M2I-CySat/CySat-1-Mission-Analysis/Two Day Ground Path/Two Day Ground Path.bmp

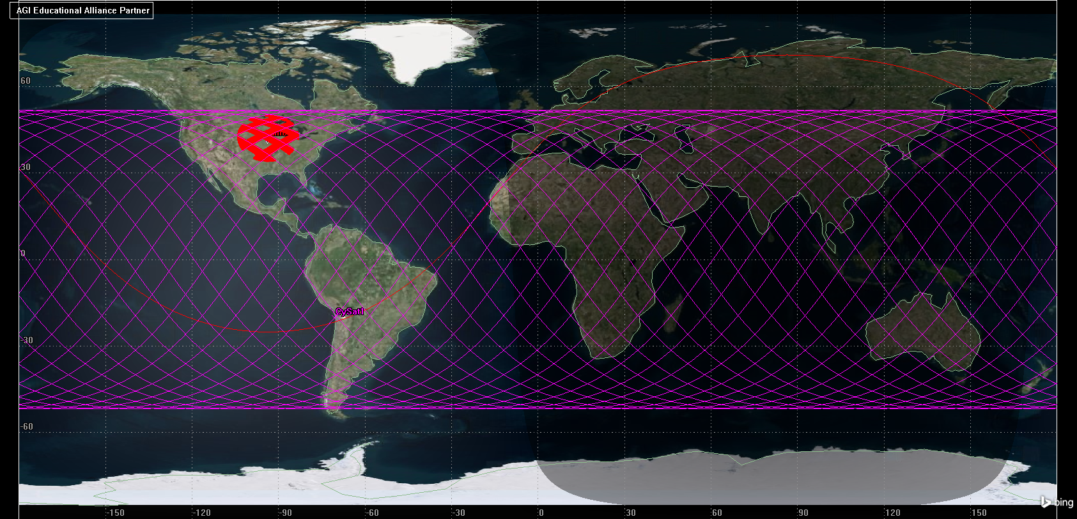
Two Day Ground Path/Two Day Ground Path.bmp
