M2I-CySat/CySat-1-Mission-Analysis/README.md

# CySat1-Mission_Analysis
CySat-1 Mission Analysis files and documentation
