M2I-CySat/CySat-1-Mission-Analysis/ConOps (3).docx

CySat-I Concept of Operations

Iowa State University

Author(s): Role

Mackenzie Kilcoin Team Lead

Jacob Goldenberg Team Member

Benjamin Sweet Team Member

Benjamin Halley Team Member

William Rickert Team Member

Matthew Nelson Faculty Advisor

Tomas Gonzalez-Torres Faculty Advisor

6 June 2018

Table of Contents

1 Mission Concept. . . . . . . . . . . . . . . . . . . . . . . . . . . . . . . . . . . . 4

2 Mission Phases. . . . . . . . . . . . . . . . . . . . . . . . . . . . . . . . . . . . . 4

2.1 Phase One. . . . . . . . . . . . . . . . . . . . . . . . . . . . . . . . . . . . . 4

2.2 Phase Two. . . . . . . . . . . . . . . . . . . . . . . . . . . . . . . . . . . . . 4

2.3 Phase Three. . . . . . . . . . . . . . . . . . . . . . . . . . . . . . . . . . . . 4

2.4 Phase Four. . . . . . . . . . . . . . . . . . . . . . . . . . . . . . . . . . . . . 4

3 Subsystem Description. . . . . . . . . . . . . . . . . . . . . . . . . . . . . . . . . 5

3.1 Structures. . . . . . . . . . . . . . . . . . . . . . . . . . . . . . . . . . . . . . 5

3.1.1 Dimensions . . . . . . . . . . . . . . . . . . . . . . . . . . . . . . . . . . . 5

3.1.2 Mass. . . . . . . . . . . . . . . . . . . . . . . . . . . . . . . . . . . . . . . 5

3.1.3 Material Composition. . . . . . . . . . . . . . . . . . . . . . . . . . . . . . 5

3.1.3.1 Micrometeoroids. . . . . . . . . . . . . . . . . . . . . . . . . . . . . . . . 5

3.1.4 Thermal Considerations. . . . . . . . . . . . . . . . . . . . . . . . . . . . . 6

3.1.5 Launch Environment. . . . . . . . . . . . . . . . . . . . . . . . . . . . . . . 6

3.2 Power. . . . . . . . . . . . . . . . . . . . . . . . . . . . . . . . . . . . . . . . 6

3.2.1 Solar Array. . . . . . . . . . . . . . . . . . . . . . . . . . . . . . . . . . . . 6

3.2.2 Electronic Power System. . . . . . . . . . . . . . . . . . . . . . . . . . . . 6 3.3 Communications and Data Handling. . . . . . . . . . . . . . . . . . . . . . . . 7

3.3.1 Radio. . . . . . . . . . . . . . . . . . . . . . . . . . . . . . . . . . . . . . 7

3.3.2 Ground Station. . . . . . . . . . . . . . . . . . . . . . . . . . . . . . . . . 7 3.3.3 Flight Computer. . . . . . . . . . . . . . . . . . . . . . . . . . . . . . . . . 7

3.3.4 Antenna Deployment. . . . . . . . . . . . . . . . . . . . . . . . . . . . . . 8

3.4 Payload. . . . . . . . . . . . . . . . . . . . . . . . . . . . . . . . . . . . . . . 8

3.4.1 Radiometer. . . . . . . . . . . . . . . . . . . . . . . . . . . . . . . . . . . 8

3.4.2 Computational Resources. . . . . . . . . . . . . . . . . . . . . . . . . . . . 8

3.4.3 AD/DAC RF Front End. . . . . . . . . . . . . . . . . . . . . . . . . . . . . . 9

3.4.4 Antenna Array. . . . . . . . . . . . . . . . . . . . . . . . . . . . . . . . . . 9

3.5 Attitude Determination and Control. . . . . . . . . . . . . . . . . . . . . . . . . 9

3.5.1 Detumbling. . . . . . . . . . . . . . . . . . . . . . . . . . . . . . . . . . . 10

3.5.1.1 Coarse Detumbling. . . . . . . . . . . . . . . . . . . . . . . . . . . . . . 10

3.5.1.2 Fine Detumbling. . . . . . . . . . . . . . . . . . . . . . . . . . . . . . . 10

3.5.2 Station Keeping. . . . . . . . . . . . . . . . . . . . . . . . . . . . . . . . . 10

3.5.2.1 Disturbances. . . . . . . . . . . . . . . . . . . . . . . . . . . . . . . . . 10

3.5.3 Momentum Desaturation. . . . . . . . . . . . . . . . . . . . . . . . . . . . 10

3.5.3.1 Desaturation. . . . . . . . . . . . . . . . . . . . . . . . . . . . . . . . . 10

1 Mission Concept

CySat at Iowa State University is designing, building, and flying a 3U CubeSat (3 Unit Cube Satellite) in Low Earth Orbit (LEO). It is to be a technology demonstrator that will be used for asteroid-surveying purposes.

2 Mission Phases

There are four main phases that CySat-I will transition through during its life. Each phase has its own purpose and is described below.

2.1 Phase One

The first phase is Passive Beacon Mode. This mode involves a beacon that when received, relays an ASCII message containing minimal system status information and a welcome message for radio amateurs. The purpose of this mode is primarily to give confirmation that CySat-I is partially functional.

2.2 Phase Two

The second phase is Diagnostic Mode. This mode involves the gathering and down-linking of data samples from the electronic power system (EPS) board that characterize CySat-I’s orbit and health status.

2.3 Phase Three

The third phase is Main Operating Mode. This mode involves the changing of operating parameters for the payload to perform any desired scientific experiments. All data is logged to the core-memory heap and down-linked during passes over Iowa

State University’s ground station.

2.4 Phase Four

The final phase is End of Life Mode. Here, the watchdog test routines will be performed to test the implemented redundancies. The attitude of CySat-I can also be adjusted during this phase to increase the drag, allowing the CubeSat to re-enter Earth’s atmosphere faster.

3 Subsystem Description

Each subsystem is contained in this section with a purpose statement along with how the subsystem functions. This should quickly acquaint the user as to what hardware and software is aboard CySat-I, why the subsystem is critical to the operation of the CubeSat, and what protocols are being utilized. Ideally, this document will provide any experienced user with the information necessary to communicate and control CySat-I as well as troubleshoot any potential problems that may arise over its lifetime.

3.1 Structures

This subsystem is focused on the physical design of the CySat-I skeleton. Size, shape, and mass all affect the final shell of the CubeSat. Since CubeSats follow a template, the shape is limited to a rectangular prism, the dimensions are constrained to that of the 3U specifications, and the mass has an upper limit.

3.1.1 Dimensions

The dimensions of CySat-I is limited to that of three, 1U CubeSats. Since each 1U is 10 cm²; that means that CySat-I’s dimensions will be 10 × 10 × 34, with the extra 4 cm coming from the excess material of the feet and allowed tolerances of outside material. While there is some slight buffer room for stowed, deployable components, these dimension specifications are relatively strict to adhere to the NanoRacks CubeSat Deployer (NRCSD) that it will launch from.

3.1.2 Mass

CubeSats also have mass limitations. There are multiple reasons for this, with the main reason being that CubeSats are getting a free ride to their destination, so there is a limit to how much extra mass a rocket can deliver. 3U CubeSats are limited to a maximum mass of 4.8 kg, however CySat-I’s mass will be less than this. The current mass of CySat-I is 2.6 kg.

3.1.3 Material Composition

The shell of CySat-I is made of 6061-T6 Aluminum. The other structural components, such as rods, spacers, and screws, will be composed of 18-8 Stainless Steel.

3.1.3.1 Micrometeoroids

Research suggests that the ISS receives a lot of micrometeoroid impacts, but many of them are under 1 cm which poses no danger to the ISS. Micrometeoroids larger than 1 cm are in the danger zone as they can cause catastrophic failure and are not tracked by stations on Earth. Since the structure’s thickness is set by the design template, there is not much that can be done to prevent impacts. If there is a large impact, a total mission failure will likely occur.

3.1.4 Thermal Considerations

The temperature gradient that the ISS experiences (due to its altitude and attitude) is extremely important to consider when selecting material composition, instrumentation placement, and a heat control system. To begin, the temperature swing that the ISS experiences can be as low as -157◦C to as high as 121◦C. The material chosen has been proven to handle a temperature gradient as large as this, however, it is important that there is a method to dissipate as well as to retain the heat from both the environment and internal components. Currently, there are plans for passive thermal control, meaning heat sinks to the structure or metal blocks if there is enough space. The EPS itself does have a form of active thermal control.

3.1.5 Launch Environment

The two loads that structures is focused on will be the static loading and random vibrations due to the launch forces of the rocket, as well as the shock force due to stage separation and deployment. To ensure mission success, a vibration test will take place prior to CySat-I’s departure.

3.2 Power

The purpose of the power subsystem is to appropriately provide and distribute power to all the subsystems. The power system is comprised of two primary components: the solar array and the EPS Because the batteries will be mated to the EPS, they are not considered a third component. During daytime, light that strikes solar array will power the satellite and recharge the batteries so that during eclipse periods, the satellite can run off of battery power.

3.2.1 Solar Array

At the moment, it is known that CySat-I will utilize an in-house built solar array to power the various subsystems. The original plan was to create an in-house solar array using two types of solar cells, the Spectrolab XTJ Prime solar cell and the Trisolax T01 solar wing, in an effort to maximize solar absorption. Both cells are SolarCell-Interconnect-Coverglass (CIC). Some of the Spectrolab XTJ Prime solar cells were donated to the university from a previous ISS mission and are being tested to ensure the same efficiency as those bought directly from the shelf. As many as twelve of these cells will be deployed with CySat-I.

3.2.2 Electronic Power System

CySat-I will employ a COTS EnduroSat EPS. At this time, two Lithium-ion Polymer (LiPo) batteries are being used. The mission was planned primarily around one 20 Wh battery, but this estimate awaits the arrival of the EPS system slated for the end of June. The batteries will be mated to the EPS. The constraints that will determine this number will be found from solar exposure experience (which can be approximated to that of the International Space Station) and the power usage per system. Currently, a full power budget is about 14 Wh but requires further testing of physical components prior to completion.

3.3 Communications and Data Handling

The purpose of the communications system is to provide telemetry, command, and control to and from Earth. The purpose of command is quite literally to command the system as a whole to perform operations. This is the most important part of CySat-I because a failure in the command software could lead to a mission critical failure. Since no communication can be performed for approximately 90 minutes following deployment, the CubeSat must be able to act autonomously in order to perform system checks and to enable communication to take place. The communication engagement will allow the ground station at ISU to attempt contact with CySat-I for control as well as allow radio amateurs receive a welcome message beacon. The hardware that comprises the command subsystem consists of two auxiliary boards: a custom in-house flight computer and two variations of control circuitry.

3.3.1 Radio

CySat-I will use an AstroDev He-100 radio to perform communication tasks. The radio will use an up-link frequency in the very high frequency (VHF) 2 m band (144 to 146 MHz) and a down-link frequency in the ultra-high frequency (UHF) 70 m band (435 to 438 MHz). By selecting frequency bands in the low end of the HF range, well into the mm range, it is possible to minimize the technical requirements of the satellite and maximize the ease-of-use by ground personnel and amateur radio operators. These two bands allow the lowest level FCC issues amateur radio license holders (i.e. technician level) to operate with CySat-I. The radio provides 1200 baud audio frequency-shift keying (AFSK) and 9600 Gaussian Minimum Shift Keying (GMSK) and AX.25 framing for ease of use. The system will be responsive to published commands from amateurs to query satellite state. Using cryptographic peripheral of MCV, mission critical control messages will be authenticated via a Hash-Based Message Authentication Code.

3.3.2 Ground Station

The software for the ground tracking of CySat-I will be a lights out, hands off, autonomous ground control system. The existing hardware facilitates flexible, reliable data communication on a range of frequencies appropriate for satellite operation. Open MCT, a mission control framework software developed by NASA, is being used for the graphical user interface (GUI).

3.3.3 Flight Computer

The flight computer contains two identical STM32F4 32 bit ARM micro-controller units (MCU) for redundancy; one as the primary unit and the other as the secondary “watchdog” unit in the case of a failure of the primary. The main memory consists of four 1 Mbit external ferromagnetic memory integrated circuit (IC). The lower-half of each IC will be dedicated to radiation resistant firmware back-ups, cryptographic keys, and various other sensitive data items. The upper-half of each IC will be combined to form a large heap for data storage prior to down-link. This will form 512 KB of main memory. The primary multipoint control unit (MCU) software has been developed around FreeRTOS and the basic peripheral library for the STM 32. A multi-threaded approach was taken for the device drivers. The following tasks run in dedicated threads:

- Universal asynchronous receiver-transmitter (UART) communication with radio
- Command parsing and protocol layer
- Command handling, configuration, and response generation
- Main memory access
- Beacon

SPI and I2C are not handled by dedicated threads. Each of these buses uses a mutex- protected direct memory access (DMA) driver to allow a single thread to seize the bus and perform high-throughput data transfer while another thread is allowed to run. The flexibility of the STM 32 standard peripheral library allows for advanced low-level access to the MCU including a UART boot-loader that can be used to perform an emergency re-flash of the MCU in the case of radiation corruption. Identical firmware will be on both MCUs. The difference in functionality will be set by hardware general-purpose input/output (GPIO) configurations and detected at startup. Each MCU will force the invalid one to reset and reprogram it with a firmware image from main memory. The primary-watchdog configuration will provide resistance to radiation corruption.

3.3.4 Antenna Deployment

The antenna that will be used for communication between CySat-I and the Ames Ground Station will be composed of a tape measure. It will be strapped down to the sides of CySat-I, held in that position by ultra-high-molecular-weight polyethylene (Spectra) fishing wire that will be tied around a 1 cm thick filament of nichrome. A burner circuit will apply a 0.5 A current which will burn the Spectra fishing wire, deploying the antennas by utilizing the spring force of the displaced tape measure.

3.4 Payload

The purpose of the payload is to give CySat-I the sensors it needs to perform its scientific mission.

3.4.1 Radiometer

The radiometer will passively measure radiant flux from the soil below in order to map soil moisture. This system will be comprised of a single horn antenna, multiple low-noise amplifiers and band-pass filters, and a software-defined radio. Because a software-defined radio is coupled to the radiometer, the system will have high levels of flexibility and adaptability while operating in LEO.

3.4.2 Computational Resources

A Xilinx Zynq chipset combines the programmable logic of a traditional field-programmable gate array for pipelining radio frequency processing, with a duel core advanced reduced instruction set computing machine Cortex fixed logic. This unifies the computational resources of the computational matrix representation (CMR) and decreases system complexity over a more distributed design. This does create a singular point of failure for the radar system, however, architectures with separated programmable logic (PL) and fixed logic (FL) suffer from the same poor survivability in the event of a failure of one of the subsystems.

3.4.3 AD/DAC RF Front End

At the moment, the specifics of the radio frequency (RF) front end are not known, where the specifics include the number of low-noise amplifiers (LNA’s) and band pass filters (BPF’s), supporting devices, and performance estimates. What is known, however, is the fact that LNA’s and BPF’s will be present on the RF frond end. The LNA’s will be arranged according to the amount of noise generated by the device—the LNA with the least amount of noise generation will be first, followed by LNAs with larger noise generation in increasing order. This arrangement will incur the least amount of noise generated by the system as a whole.

3.4.4 Antenna Array

The antenna array for the radiometer will be comprised of a single horn antenna, created in-house. Phased arrays create the performance of a much larger antenna, and will be necessary to create the necessary gain for optimal radiometer operation. Primary operational goals include detecting and mapping the distribution of radiant flux over time. The single horn antenna will be placed on the front face of the CubeSat. The radiometer will receive signal on the internationally-protected frequency of 1.4 to 1.41 GHz, so the antenna array will be capable of reading these signals.

3.5 Attitude Determination and Control

The attitude, determination, and control system (ADCS) is responsible for orienting CySat-I is in space. CySat-I’s ADCS system was purchased from CubeSpace and consists of both an Earth sensor and a Sun sensor, a magnetometer, 3 magnetic coils (magnetorquers) and a single reaction wheel. The system is composed of three types of components: sensors, controls, and actuators. The sensors are responsible for gathering the relevant telemetry so that the current orientation of the satellite can be determined. The control algorithms process this information and send commands to the actuators. The actuators then turn the spacecraft to the desired orientation. CySat-I is an Earth-observing nadir-pointing satellite. This is the main goal of the ADCS, however it will also have to successfully stabilize the spacecraft from its initial tumbling motion after deployment. This section will focus on the four main parts of the attitude determination and control subsystem: detumbling, station keeping, momentum desaturation, and contingencies.

3.5.1 Detumbling

When ejected from the dispenser, the spacecraft can be expected to have a tumbling rate of up to 300◦/s. The tumbling rate post deployment will exceed the maximum slew rate that the optical sensors can determine the position during. As such, a passive detumbling capability is required. Passive detumbling will be achieved with magnetic torque rods which will be turned on automatically as part of the early startup of the spacecraft. The magnetorquers produce a control torque calculated from the magnetometer reading of Earth’s magnetic field. The net torque produced via interaction with earth’s magnetic field is weak and the coarse detumbling process is expected to take on the order of hours to achieve a stable slew rate. An inertial measurement unit will determine the angular rate. When the slew rate is under a certain threshold, the control software will begin producing control torques that align the satellite in its proper nadir plane, and spinning down the satellite so that it stays pointed at the earth. At this point the momentum wheel will spin up, which provides gyroscopic stability in the orbit/nadir plane, rejecting disturbance torques more easily than the magnetorquers. Detumbling is complete when CySat-I has achieved a steady nadir pointing state where angular position can be held with ±2 degrees of accuracy.

3.5.2 Station Keeping

To remain pointed at Earth below, the spacecraft will have to rotate one full revolution per orbit. At an orbital period of approximately 90 min, this amounts to 4◦/s. If the spacecraft’s z-axis is aligned with the velocity vector, this rotation takes place purely in the Y-Z plane and is maintained with the momentum wheel. Otherwise, it will involve an angular position change of all three axes. This will be computed and executed autonomously by the ADCS.

3.5.2.1 Disturbances

There are four major disturbances that will affect the station keeping of CySat-I. These disturbances are a source of constant torque that can add to momentum saturation of the momentum wheel. Worst case magnitudes of these torques are a gravity gradient of 0.44 N mm, a magnetic dipole of 6.0 × 10⁻⁴ N mm, solar radiation pressure of 1.91 × 10⁻⁵ N mm, and aerodynamic drag of 1.56 × 10⁻⁴ N mm.

3.5.3 Momentum Desaturation

The momentum wheel has a maximum spin rate and therefore can only reject torque for a certain amount of time before becoming saturated at the max spin rate. At this point the momentum wheel must be spun down, however, doing so imparts the angular momentum that is stored in the wheel back into the spacecraft’s motion. As such, a secondary actuator is needed to reject this momentum in the desaturation procedure.

3.5.3.1 Desaturation

Magnetorquers are used to desaturate the momentum. A magnetic moment is created by activating the magnetorquer. The direction of this torque depends on the direction of the Earth’s magnetic field at the time, which can be determined with a magnetometer. The magnetorquers are activated in such a way that the net magnetic torque acts opposite the torque created by spinning down the reaction wheel. The maximum magnitude of the magnetic torque dictates the rate at which the reaction wheel can be spun down. Once the wheel has been spun down to zero speed, the magnetorquer is turned off.

Concept of Operations Page | 11
