M2I-CySat/CySat-1-Mission-Analysis/EnduroSat BOM 07Feb2018 copy.xlsx

Classification: (if proprietary)
EnduroSat 1
Material | Quantity | Unit* Mass (g) | Total Mass (g) | Unit Surface Area cm2 | Usage
EPS
PCB material - FR4 | 1 | 34.8 | 34.8 | 83.9 | PCB (one side)
Aluminum 6061 | 1 | 72 | 72 | - | EPS box
NC-SMQ 92H solder paste | 1 | 1 | 1 | 1 | Solder paste
Black Glass Filled Polyester (see datasheet) | 1 | 31.6 | 31.6 | 42 | PC 104 Connector (insulator material) (http://suddendocs.samtec.com/catalog_english/esq_th.pdf)
High Termoplatic Thermoplastic resin (see datasheet) | 9 | 0.3 | 2.7 | - | connectors (http://bg.farnell.com/molex/53261-0471/wire-board-connector-header-4pos/dp/2424535?mckv=sBVXa6kQi_dc|pcrid|93196729276|kword|53261%200471|match|p|plid|&CMP=KNC-GBG-GEN-SKU-MOLEX&DM_PersistentCookieCreated=true&gclid=Cj0KCQjw9afOBRDWARIsAJW4nvyeg_RIJQo7JQt4OeyoRIKf3Q2n4Pk5UAv5hqWSUEikG8ZtKXl78HwaAkAiEALw_wcB)
Stainless steel 10.9 | 2 | 0.9 | 1.8 | - | M3 fasteners
Common circuit board components materials (capacitors, resistors, inductors, etc.) | 1 | 10 | 10 |  | Components
Battery pack (2x)
PCB material - FR4 | 1 | 15.3 | 15.3 | 58.8 | PCB
Loctite Stycast 4350 | 1 | 7.5 | 7.5 | 52.3 | Thermal conductive silicon rubber
NC-SMQ 92H solder paste | 1 | 0.5 | 0.5 | 0.5 | Solder paste
Li-po batteries | 2 | 25 | 50 | - | Batteries
Brass | 2 | 0.3 | 0.6 | - | Spacers
Common circuit board components materials (capacitors, resistors, inductors, etc.) | 1 | 3 | 3 |  | Components
