M2I-CySat/CySat-1-Mission-Analysis/main.SLDPRT

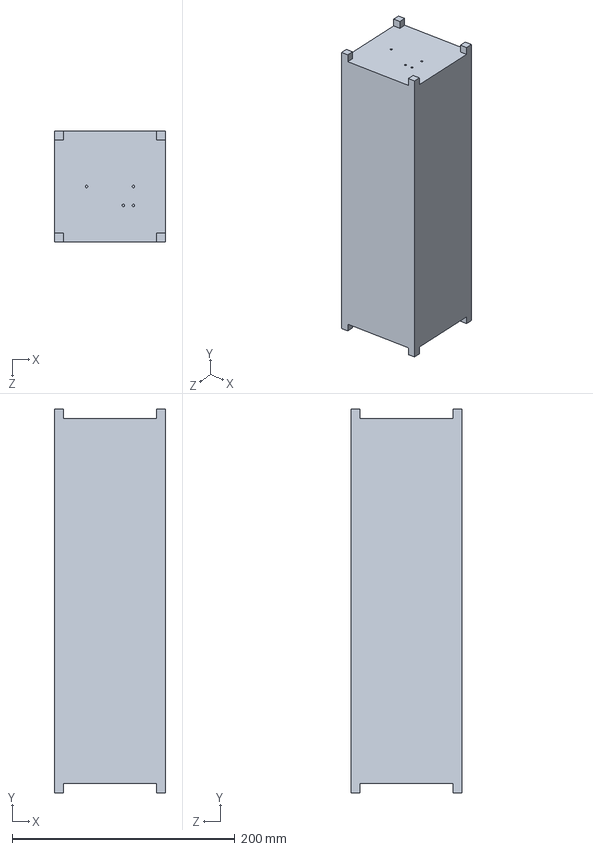
[picture p2: CAD file, 2018-06-22]
main.SLDPRT
100.0 x 344.5 x 100.0 mm
