M2I-CySat/CySat-1-Mission-Analysis/lowfi.SLDASM

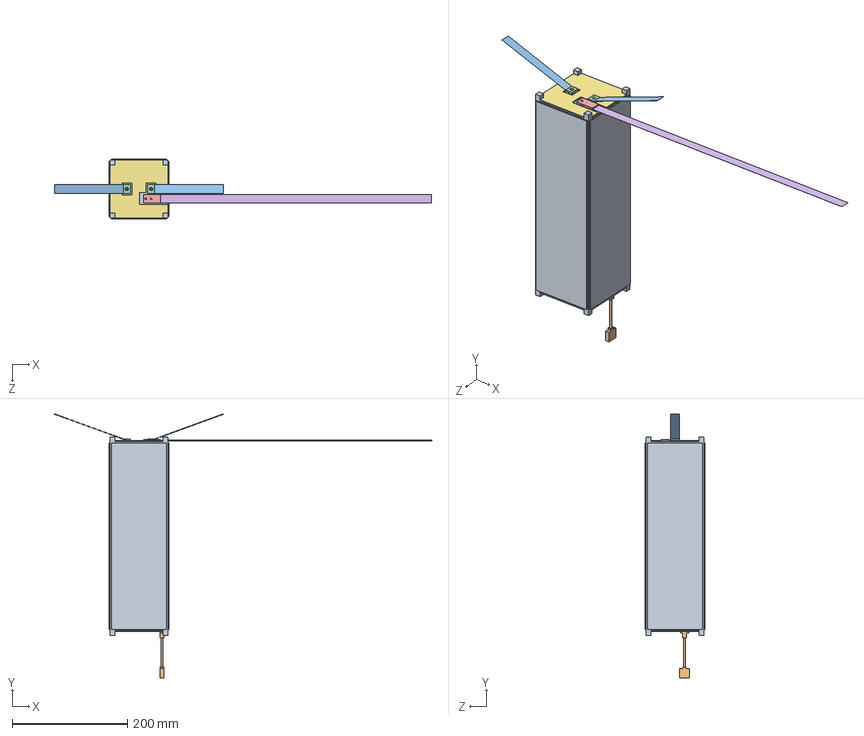
[picture p3: CAD file, 2018-06-22]
lowfi.SLDASM
654.1 x 458.0 x 104.0 mm
main
Dipole Antenna Mount Bottom x 2
Dipole Deployed x 2
Dipole Antenna Mount Top x 2
Mono Antenna Mount Bottom x 2
Monopole Deployed
top panel1
bottom panel
side panel x 4
mag
