M2I-CySat/CySat-1-Mission-Analysis/top panel1.SLDPRT

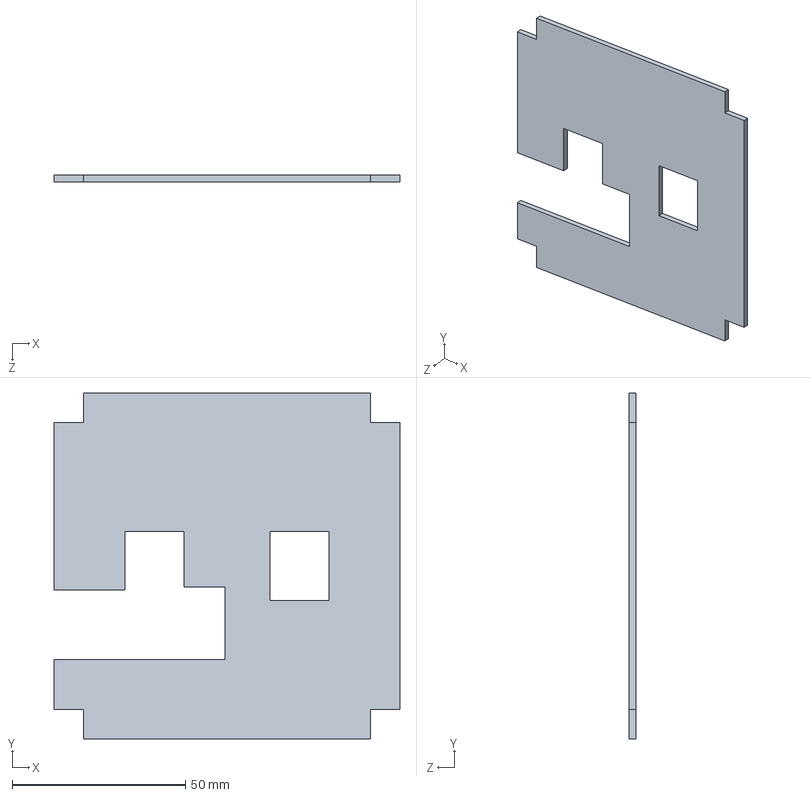
[picture p4: CAD file, 2018-06-22]
top panel1.SLDPRT
100.0 x 100.0 x 2.00 mm
