M2I-CySat/CySat-1-Mission-Analysis/mag.SLDPRT

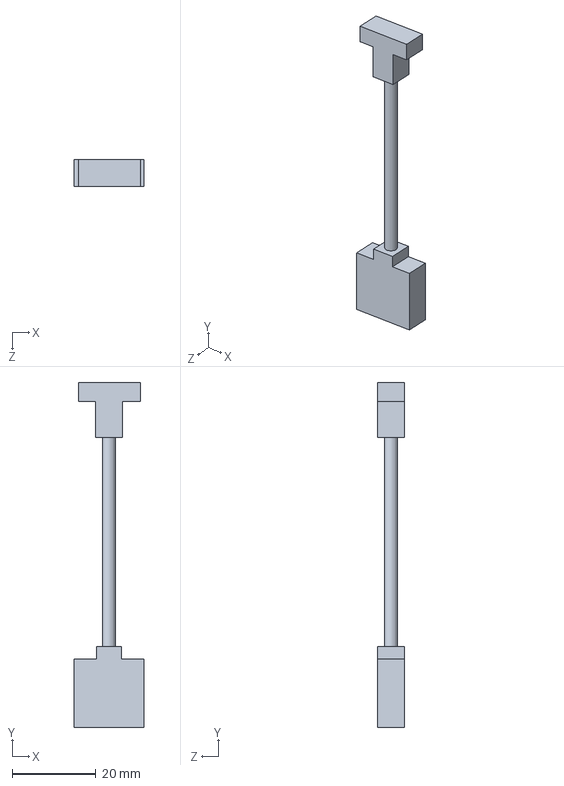
[picture p5: CAD file, 2018-06-22]
mag.SLDPRT
16.8 x 82.5 x 6.50 mm
