M2I-CySat/CySat-1-Mission-Analysis/side panel.SLDPRT

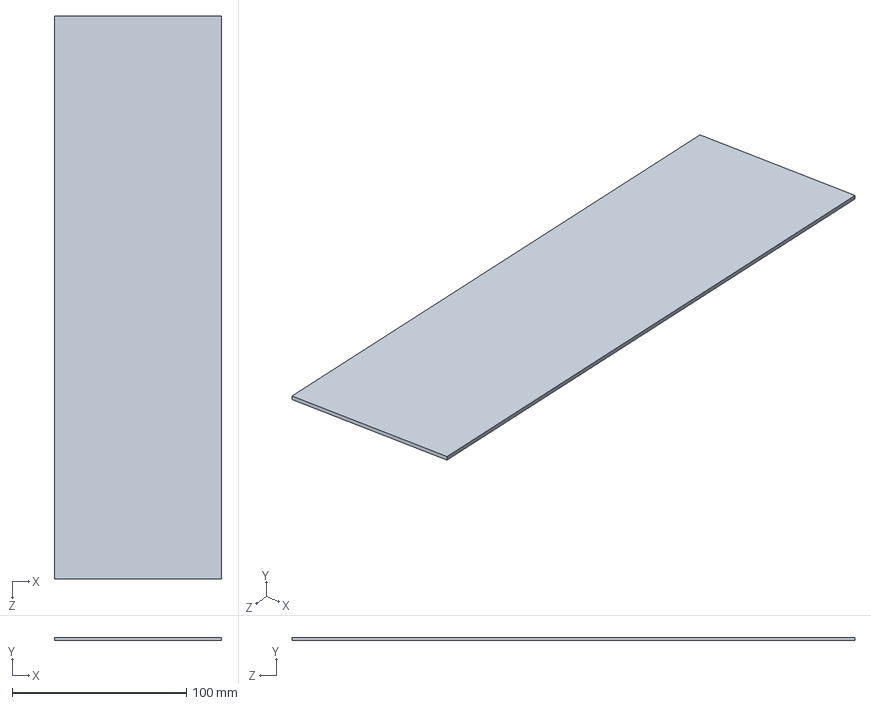
[picture p6: CAD file, 2018-06-22]
side panel.SLDPRT
96.0 x 2.00 x 323.5 mm
