M2I-CySat/CySat-1-Mission-Analysis/(list of files, cad)

Other CAD files:
bottom panel.SLDPRT
lowfi.SLDPRT
lowfi.STL
