M2I-CySat/CySat-1-Mission-Analysis/Concept of Operations.pdf

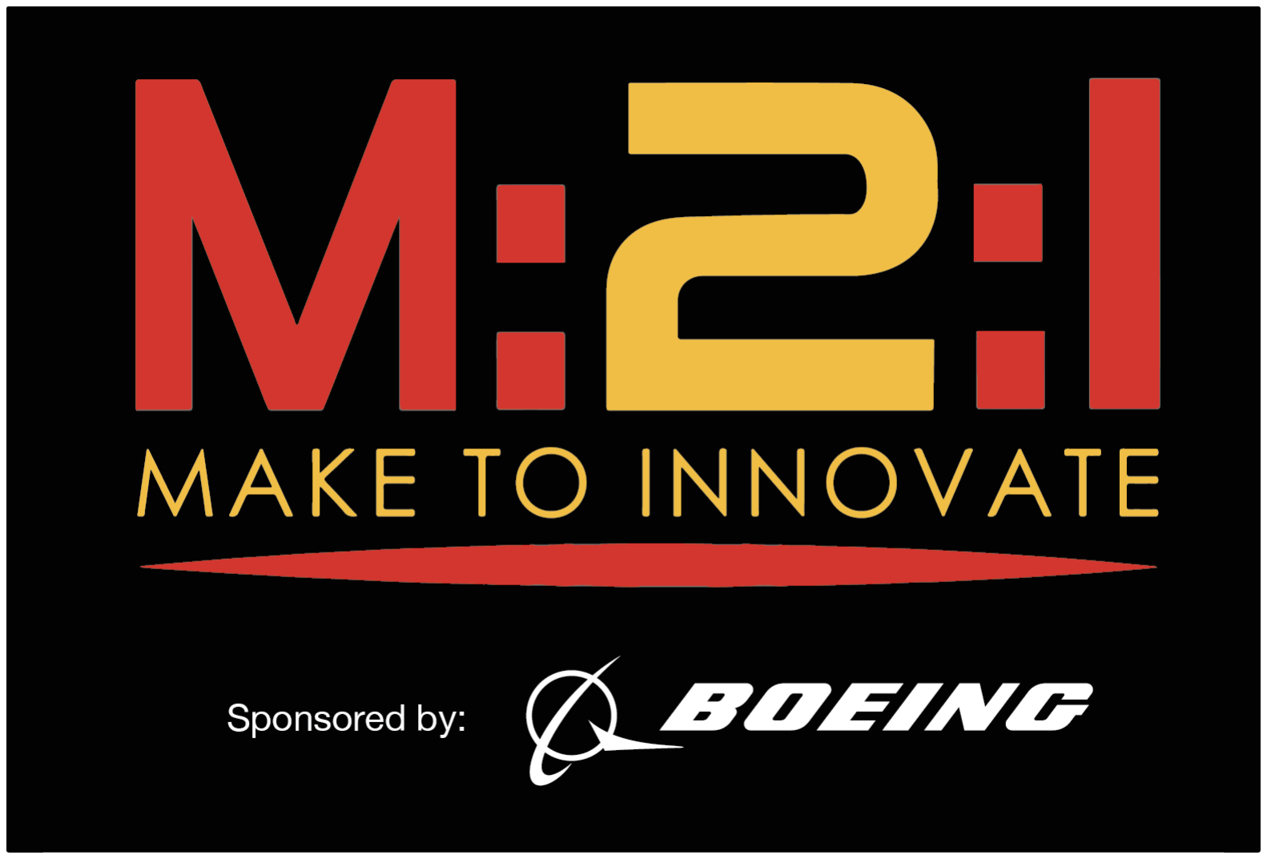
[picture p7: figure]

Iowa State University

AerE 294X/AerE 494X

Make to Innovate

# CySat-1 Concept of Operations

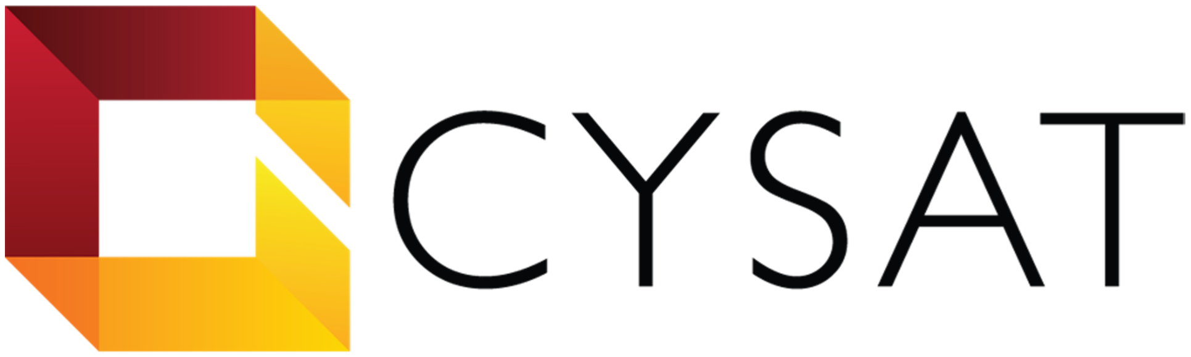
[picture p8: figure]

Project: CySat
Team: Mission Analysis

### Author(s): Jacob Goldenberg

### Role: Team Member

### Faculty Advisers: Matthew E. Nelson and Tomas Gonzalez-Torres

### September 1, 2017

CySat-1 Concept of Operations Jacob Goldenberg

## Contents

1 Mission Concept | 3
2 Mission Phases | 3
3 Subsystem Description | 4

1

CySat-1 Concept of Operations Jacob Goldenberg

2

CySat-1 Concept of Operations Jacob Goldenberg

## 1 Mission Concept

CySat at Iowa State University is designing, building, and flying a 3U CubeSat in Low Earth Orbit (LEO). It is to be a technology demonstrator that will be used for asteroid-surveying purposes.

## 2 Mission Phases

There are four main phases that CySat-I will transition through during its life. Each phase has its own purpose and is described below.

### 2.1 Phase One

Phase One is called Passive Beacon Mode. This mode involves a beacon that when received, relays an ASCII message containing minimal system status information and a welcome message for radio amateurs.. The purpose of this mode is primarily to give confirmation that CySat-I is partially functional.

### 2.2 Phase Two

Phase Two is known as Diagnostic Mode. This mode involves the gathering and down-linking of data samples from the EPS board that characterize CySat-I’s orbit and health status.

### 2.3 Phase Three

Phase Three is known as Main Operating Mode. This mode involves the changing of operating parameters for the payload to perform any desired scientific experiments. All data is logged to the core-memory heap and down-linked during passes over Iowa State University’s ground station.

### 2.4 Phase Four

Phase Four is known as End of Life Mode. Here, the watchdog test routines will be performed to test the implemented redundancies. The attitude of CySat-I can also

3

CySat-1 Concept of Operations Jacob Goldenberg

be adjusted during this phase to increase the drag, allowing the CubeSat to re-enter Earth’s atmosphere faster.

## 3 Subsystem Description

Each subsystem is contained in this section with a purpose statement along with how the subsystem functions. This should quickly acquaint the user as to what hardware and software is aboard CySat-I, why the subsystem is critical to the operation of the CubeSat, and what protocols are being utilized. Ideally, this document will provide any experienced user with the information necessary to communicate and control CySat-I, as well as troubleshoot any potential problems that may arise over its lifetime.

### 3.1 Structures

This subsystem is focused on the physical design of the CySat-I skeleton. Size, shape, and mass all affect the final shell of the CubeSat. Since CubeSats follow a template, the shape is limited to a rectangular prism, the dimensions are constrained to that of the 3U specifications, and the mass has an upper limit.

### 3.1.1 Dimensions

The dimensions of CySat-I is limited to that of three, 1U CubeSats. Since each 1U is 10 cm²
, that means that CySat-I’s dimensions will be 10 × 10 × 34.5 cm. While there is some slight buffer room for stowed, deployable components, these dimension specifications are relatively strict to adhere to the NanoRacks CubeSat Deployer (NRCSD) that it will launch from.

### 3.1.2 Mass

CubeSats also have mass limitations. There are multiple reasons for this, with the main being that CubeSats are getting a free ride to their destination, so there is a limit to how much extra mass a rocket can take to its destination. 3U CubeSats are limited to a maximum mass of 4.8 kg, however CySat-I’s mass will be less than this. The current mass of CySat-I is 2.9 kg.

4

CySat-1 Concept of Operations Jacob Goldenberg

### 3.1.3 Material Composition

The shell of CySat-I is made of 6061-T6 Aluminum. The other structural components, such as rods, spacers, and screws, will be composed of 18-8 Stainless Steel.

### 3.1.3.1 Micrometeoroids

Research suggests that the ISS receives a lot of micrometeoroid impacts, but many of them are under 1 cm which poses no danger to the ISS. Micrometeorites larger than 1 cm are in the danger zone as they can cause catastrophic failure and are not tracked by stations on Earth. Since the structure’s thickness is set by the design template, there is not much that can be done to prevent impacts. If there is a large impact, a total mission failure will likely occur.

### 3.1.4 Thermal Considerations

The temperature gradient that the ISS experiences (due to its altitude and attitude) is extremely important to consider when selecting material composition, instrumentation placement, and a heat control system. To begin, the temperature swing that the ISS experiences can be as low as -157 ◦C to as high as 121 ◦C. The material chosen has been proven to handle a temperature gradient as large as this, however, it is important that there is a method to dissipate as well as to retain the heat from both the environment and internal components. Currently, there are plans for passive thermal control, meaning heat sinks to the structure or metal blocks if enough space. The EPS itself does have a form of active thermal control.

### 3.1.5 Launch Environment

The two loads that structures is focused on will be the static loading and random vibrations due to the launch forces of the rocket, as well as the shock force due to stage separation and deployment.

### 3.2 Power

The purpose of the power subsystem is to appropriately provide and distribute power to all the subsystems. The power system is comprised of two primary components: the solar array and the electronic power system (EPS). Depending on if the batteries will be separated or mated, batteries would be considered a third component. During

5

CySat-1 Concept of Operations Jacob Goldenberg

day passes the solar array will power the satellite and recharge the batteries so that during eclipse periods the satellite can run off of battery power.

### 3.2.1 Solar Array

At the moment, it is unknown if CySat-I will use a built in-house solar array, or commercial off the shelf (COTS) to obtain power. The original plan was to create an in-house solar array using two solar cells, the Spectrolab XTJ Prime solar cell and the Trisolax T01 solar wing, in an effort to maximize solar absorption. Both cells are SolarCell-Interconnect-Coverglass (CIC). The COTS option is to purchase panels directly from Clyde Space.

### 3.2.2 Electronic Power System

CySat-I will employ a COTS Clyde Space EPS. At this time, the number of Lithiumion Polymer (LiPo) batteries being used is unknown, but everything is currently being planned around one 20 W h battery. It is unknown if the batteries will be separate or mated to the EPS. The constraints that will determine this number will be determined from solar exposure experience (which can be approximated to that of the International Space Station) and the power usage per system. Currently, a full power budget is unknown.

### 3.3 Communications and Data Handling

The purpose of the communications system is to provide telemetry, command, and control to and from Earth.

The purpose of command is quite literally to command the system as a whole to perform operations. This is the most important part of CySat-1, because a failure in the command software could lead to a mission critical failure. Since no communication can be performed for 45 minutes following deployment, the CubeSat must be able to act autonomously in order to perform system checks and to enable communication to take place. The communication engagement will allow the ground station at Ames to attempt contact with CySat-1 for control as well as allow radio amateurs receive a welcome message beacon.

The hardware that comprises the command subsystem consists of two auxiliary boards: a custom in-house flight computer and two variations of control circuitry.

6

CySat-1 Concept of Operations Jacob Goldenberg

### 3.3.1 Radio

CySat-I will use a CPUT-VUTRX or an AstroDev He-100 radio to perform communication tasks. It is currently unknown as to which radio will be used. The AstroDev is cheaper because it has already been purchased, but it is not as powerful and it is unknown if the manufacturer will be able to fix it as it is currently broken. The radio will use an up-link frequency in the very high frequency (VHF) 2 m band (144 to 146 MHz) and a down-link frequency in the ultra high frequency (UHF) 70 m band (435 to 438 MHz). By selecting frequency bands in the low end of the HF range, well into the mm range, it is possible to minimize the technical requirements of the satellite and maximize the ease-of-use by ground personnel and amateur radio operators. These two bands allow the lowest level FCC-issues amateur radio license holders (i.e. technician level) to operate with CySat-I. The radio provides 1200 baud audio frequency-shift keying (AFSK) and 9600 Gaussian Minimum Shift Keying (GMSK) and AX.25 framing for ease of use. The system will be responsive to published commands from amateurs to query satellite state. Using cryptographic peripheral of MCV, mission critical control messages will be authenticated via a Hash-Based Message Authentication Code.

### 3.3.2 Ground Station

The software for the ground tracking of CySat-I will be a lights out, hands off, distributed autonomous ground control system. The existing hardware facilitates flexible, reliable data communication on a range of frequencies appropriate for satellite operation. Open MCT, a mission control framework software developed by NASA, is being used for the graphical user interface (GUI).

### 3.3.3 Flight Computer

The flight computer contains two identical STM32F4 32 bit ARM micro-controller units (MCU) for redundancy; one as the primary unit and the other as the secondary “watchdog” unit in the case of a failure of the primary. The main memory consists of four 1 Mbit external ferromagnetic memory integrated circuit (IC). The lower-half of each IC will be dedicated to radiation resistant firmware back-ups, cryptographic keys, and various other sensitive data items. The upper-half of each IC will be combined to form a large heap for data storage prior to down-link. This will form 512 KB of main memory.

The primary multipoint control unit (MCU) software has been developed around FreeRTOS and the basic peripheral library for the STM 32.

7

CySat-1 Concept of Operations Jacob Goldenberg

A multi-threaded approach was taken for the device drivers. The following tasks run in dedicated threads:

- Universal asynchronous receiver-transmitter (UART) communication with radio
- Command parsing and protocol layer
- Command handling, configuration, and response generation
- Main memory access
- Stabilization control (It is unknown whether the flight computer will be responsible for this at this time)
- Beacon

SPI and I2C are not handled by dedicated threads. Each of these buses uses a mutexprotected direct memory access (DMA) driver to allow a single thread to seize the bus and perform high-throughput data transfer while another thread is allowed to run. The flexibility of the STM 32 standard peripheral library allows for advanced low-level access to the MCU including a UART boot-loader that can be used to perform an emergency re-flash of the MCU in the case of radiation corruption. Identical firmware will be on both MCUs. The difference in functionality will be set by hardware general-purpose input/output (GPIO) configurations and detected at startup. Each MCU will force the invalid one to reset and reprogram it with a firmware image from main memory. The primary-watchdog configuration will provide resistance to radiation corruption.

### 3.3.4 Antenna Deployment

The antenna that will be used for communication between CySat-I and the Ames Ground Station will be composed of a tape measure. It will be strapped down to the sides of CySat-I, held in that position by ultra-high-molecular-weight polyethylene (Spectra) fishing wire that will be tied around a 1 cm thick filament of nichrome. A burner circuit will apply a 0.5 A current which will burn the Spectra fishing wire, deploying the antennas by utilizing the spring force of the displaced tap measure.

### 3.4 Payload

The purpose of the payload is to give CySat-I the sensors it needs to perform its scientific mission.

8

CySat-1 Concept of Operations Jacob Goldenberg

### 3.4.1 Radiometer

The radiometer will passively measure radiant flux from the soil below in order to map soil moisture. This system will be comprised of a phased-array antenna, multiple low-noise amplifiers and band-pass filters, and a software-defined radio. Because a software-defined radio is coupled to the radiometer, the system will have high levels of flexibility and adaptability while operating in LEO.

### 3.4.2 Computational Resources

A Xilinx Zynq chipset combines the programmable logic of a traditional fieldprogrammable gate array for pipelining radio frequency processing, with a duel core advanced reduced instruction set computing machine (A(RISC)M) Cortex fixed logic. This unifies the computational resources of the computational matrix representation (CMR) and decreases system complexity over a more distributed design. This does create a singular point of failure for the radar system, however, architectures with separated programmable logic (PL) and fixed logic (FL) suffer from the same poor survivability in the event of a failure of one of the subsystems.

### 3.4.3 AD/DAC RF Front End

At the moment, the specifics of the radio frequency (RF) front end are not known, where the specifics include the number of low-noise amplifiers (LNA’s) and band pass filters (BPF’s), supporting devices, and performance estimates. What is known, however, is the fact that LNA’s and BPF’s will be present on the RF frond end. The LNA’s will be arranged according to the amount of noise generated by the device—the LNA with the least amount of noise generation will be first, followed by LNAs with larger noise generation in increasing order. This arrangement will incur the least amount of noise generated by the system as a whole.

### 3.4.4 Antenna Array

The antenna array for the radiometer will be comprised of a phased array of printed circuit board (PCB) antenna, created in-house. Phased arrays create the performance of a much larger antenna, and will be necessary to create the necessary gain for optimal radiometer operation. Primary operational goals include detecting and mapping the distribution of radiant flux over time. The exact location and performance of these antenna will be decided through PCB mapping on the exterior of the

9

CySat-1 Concept of Operations Jacob Goldenberg

satellite and testing of the fabricated antenna. The radiometer will receive signal on the internationally-protected frequency of 1.4 to 1.41 GHz, so the antenna array will be capable of reading these signals.

### 3.5 Attitude Determination and Control

The attitude, determination, and control system (ADCS) is responsible for orienting CySat-I is in space. The system is composed of three components: sensors, controls, and actuators. The sensors are responsible for gathering the relevant telemetry so that the current orientation of the satellite can be determined. The control algorithms process this information and send commands to the actuators. The actuators then turn the spacecraft to the desired orientation. CySat-I is an Earth-observing nadir-pointing satellite. This is the main goal of the ADCS, however it will also have to successfully stabilize the spacecraft from its initial tumbling motion after deployment. This section will focus on the four main parts of the attitude determination and control subsystem: detumbing, station keeping, momentum desaturation, and contingencies.

### 3.5.1 Detumbling

When ejected from the dispenser, the spacecraft can be expected to have a tumbling rate of up to 300 ◦/s.

### 3.5.1.1 Coarse Detumbling

The tumbling rate post deployment will exceeds the maximum slew rate that any sensors can determine the position during. As such, a passive detumbling capability is required. Passive detumbling will be achieved with magnetic torque rods which will be turned on automatically as part of the early start up of the spacecraft. The magnetorquers will be on full power for the duration of detumbling. The net torque produced via interaction with earth’s magnetic field is weak and the coarse detumbling process is expected to take on the order of days to achieve a slew rate that the sensors can determine attitude under. An inertial sensing unit will measure the angular rate.

### 3.5.1.2 Fine Detumbling

Once the spinning rate has been reduced under a certain threshold, position sensors can determine orientation. Sun sensors determine the sun vector which is combined

10

CySat-1 Concept of Operations Jacob Goldenberg

with time data to determine one axis of position. Dual horizon sensors detect the limb of Earth off two faces of the satellite, determining the nadir plane. With position data available, the actuators can be commanded to stabilize the craft. Reaction wheels are the primary actuator for this process. Detumbling is complete when CySat-I has achieved a steady nadir pointing state where a location can be locked in to ±1 degree of accuracy.

### 3.5.2 Station Keeping

Station keeping will be managed with a minimum of 3 reaction wheels. To remain pointed at Earth below, the spacecraft will have to rotate one full revolution per orbit. At an orbital period of approximately 90 min, this amounts to 4 ◦/s. If the spacecraft’s z-axis is aligned with the velocity vector, this rotation takes place purely in the Y-Z plane and would be controlled with one reaction wheel. Otherwise, it will involve an angular position change of all three axes. This will be computed and executed autonomously by the ADCS.

### 3.5.2.1 Eclipse

During eclipse, sun sensor data will not be available for attitude determination. The spacecraft will hold its position in the X-Z plane with inputs from the inertial sensing unit. When the spacecraft emerges from eclipse, sun sensor data will be available once again and the orientation in the X-Z plane will be corrected.

### 3.5.2.2 Disturbances

There are four major disturbances that will affect the station keeping of CySat-
I. These disturbances are a source of constant torque that can add to momentum saturation of the reaction wheels. Worst case magnitudes of these torques are a gravity gradient of 0.44 N mm, a magnetic dipole of 6.0 × 10⁻⁴ N mm, solar radiation pressure of 1.91 × 10⁻⁵ N mm, and aerodynamic drag of 1.56 × 10⁻⁴ N mm.

### 3.5.3 Momentum Desaturation

The reaction wheels have a maximum spin rate and therefore can only reject torque for a certain amount of time before becoming saturated at the max spin rate. At this point the reaction wheel must be spun down, however, doing so imparts the angular momentum that is stored in the wheel back into the spacecraft’s motion. As such, a secondary actuator is needed to reject this momentum in the desaturation

11

CySat-1 Concept of Operations Jacob Goldenberg

procedure. Further calculation is needed to determine how often desaturation will be needed.

### 3.5.3.1 Desaturation

Magnetorquers are used to desaturate the reaction wheels. A magnetic moment is created by activating the magnetorquer. The direction of this torque depends on the direction of the Earth’s magnetic field at the time, which can be determined with a magnetometer. The magnetorquers are activated in such a way that the net magnetic torque acts opposite the torque created by spinning down the reaction wheel. The maximum magnitude of the magnetic torque dictates the rate at which the reaction wheel can be spun down. Once the wheel has been spun down to zero speed, the magnetorquer is turned off.

### 3.5.3.2 Realignment

The spacecraft may experience some drift during the desaturation procedure due to differences in the alignment of the torques which are due to small changes in the direction of Earth. It is unknown whether the system can be configured to actively compensate for these differences. The reaction wheels can be used to realign the spacecraft to its nadir position once the momentum has been bled out.

### 3.5.4 Contingencies

It is important to have contingencies within the ACDS as a failure in one or more of the control devices could lead to a total mission failure.

### 3.5.4.1 Reaction Wheel Failure

### 3.5.4.1.1 Three Wheel Setup

If the primary station keeping reaction wheel fails, the spacecraft has a chance to rotate 90 degrees in the X-Z plane to make the Z-axis reaction wheel the station keeping actuator. The spacecraft Z-axis must be perfectly aligned with the velocity at the time of failure for this to be effective. This amounts to a lower probability of success during eclipse. Disturbance torques will eventually cause the spacecraft to drift out off station in a manner that cannot be corrected.

12

CySat-1 Concept of Operations Jacob Goldenberg

### 3.5.4.1.2 Four Wheel Setup

Four wheels can be placed so that if one fails, the other three can still produce a net torque in any direction. If one wheel fails, the mission is not compromised in any way. This setup is more massive and consumes more power, as some components of the torques produced by each wheel typically cancel each other out.

### 3.5.4.2 Magnetorquer Failure

With three magnetorquers, the resultant magnetic dipole is simply the vector sum of all three. If one fails, this results in a longer desaturation time. This also reduces the capability to actively produce a magnetic torque that is opposite the desaturation direction. In this case, passive desaturation may have to occur. Similar to detumbling, the momentum can be dumped out of the wheels and the remaining magnetorquers turned on until the spacecraft rights itself. The passive desaturation procedure will require that the momentum is dumped in a way that does not exceed any angular rate limit of our detumbling capabilities.

### 3.5.4.3 Sensor Failure

### 3.5.4.3.1 Sun Sensor Failure

If the sun sensor fails, CySat-I will find itself in eclipse state at all times. The inertial measurement unit (IMU) gyro can still be used to hold its current attitude, however this will not be able to be corrected if drift occurs.

### 3.5.4.3.2 Horizon Sensor Failure

If one of the horizon sensors fail, CySat-I will lose determination of its angular position in the X-Z plane unless data can be extrapolated from the sun sensor. If both sensors fail, CySat-1 loses nadir-pointing capability.

### 3.5.4.3.3 Magnetometer Failure

A magnetometer will allow the spacecraft to actively use its magnetorquers to produce a magnetic moment in a desired direction. Since this requires knowledge of the Earth’s magnetic field vector, this cannot be done without a magnetometer. Passive correction is still viable in this case.

13
