M2I-CySat/CySat-1-Mission-Analysis/2. CySat1 Updated Concept of Operations (Fall 2017)/2. CySat1 Updated Concept of Operations (Fall 2017)/Execution Timeline.xlsx

 |  | T=0 | Minutes after |  |  | Hours after |  |  |  |  |  |  |  |  |  |  |  |  |  |  |  |  |  |  |  |  |  |  | Days After |  |  |  |  |  | Weeks After |  |  | Months After |  |  |  |  |  |  |  |  |  |  | Years After |  | Near end of life | End of life
 |  |  | 15 | 30 | 45 | 1 | 2 | 3 | 4 | 5 | 6 | 7 | 8 | 9 | 10 | 11 | 12 | 13 | 14 | 15 | 16 | 17 | 18 | 19 | 20 | 21 | 22 | 23 | 1 | 2 | 3 | 4 | 5 | 6 | 1 | 2 | 3 | 1 | 2 | 3 | 4 | 5 | 6 | 7 | 8 | 9 | 10 | 11 | 1 | … | 3.3-6.6 years later
1 | RBF pin is removed
2 | Power from batteries begins flowing (resumed intermittently during eclipse periods)
3 | Latch-up and firmware corruption watchdog routines
4 | Passive Beacon mode (ASCII message containing minimal system status information and a welcome message for radio amateurs)
a | System checks
b | A command, initiated by an automated timer, will be sent to burn the Spectra fishing wire, deploying the antennas
c | Ground Station will use orbital data from NASA to attempt to pick up CySat-1's beacon
d | Reaction wheels and magnetorquers are utilized to stabilize CySat-1
e | If bi-directional contact cannot be established, the beacon will at least give confirmation that CySat-1 is partially functional
f | Once contact has been established, a command will be sent to transition CySat-1 to diagnostic mode
5 | Diagnostic mode
a | Gathering high-frequency data samples from the EPS board and logging the data to the core-memory heap
b | Data can be downlinked and analyzed to characterize CySat-1's orbit and health status
c | Health and housekeeping data gathered
d | A command will be sent to transition CySat-1 to the main operating mode
6 | Main Operating mode
a | Operating parameters may be configured
b | Health and housekeeping
i | Data gathering--at lower rate than diagnostic mode--and logging the data to the core-memory heap
ii | Data rates can be adjusted and configured based on power consumption figures
c | Payloads routines active
d | A command will be sent to transition CySat-1 to the end of life mode
7 | End of life mode
a | Watchdog test routines
b | Attitude will be adjusted to maximize drag to allow CySat-1 to re-enter Earth's atmosphere
