M2I-CySat/CySat-1-Mission-Analysis/(commit log)

2018-05-29 Mission Analysis Files
    [ELaNa ODAR Component v1.1 (1) (1).xlsx, Execution Timeline.xlsx, NanoRacks BOM Template (1).xlsx]
2018-05-31 Referenced in 5/31 NR Meeting
    ECL Template and NR ISS are the export documents needed by late June
    Investigation Summary form needed by mid June
    ODAR Component List needs Antenna updated
    [ELaNa ODAR Component v2.0.xlsx, EnduroSat BOM 07Feb2018 copy.xlsx]
2018-06-19 Regulatory Documents
    Updated ConOps, Orbital Debris Assessment, and commented NOAA
2018-06-22 Add files via upload
    3D model files for the STK power simulation
    [bottom panel.SLDPRT, lowfi.SLDASM, lowfi.SLDPRT, lowfi.STL, mag.SLDPRT, main.SLDPRT, side panel.SLDPRT, top panel1.SLDPRT]
2018-06-22 3D model files for the STK power simulation
2018-07-05 PC104 Online Document
    [PC104.xlsx]
